Sinclair81/Lux-Air-Sensor/Lux-Air-Sensor_Bottom.png

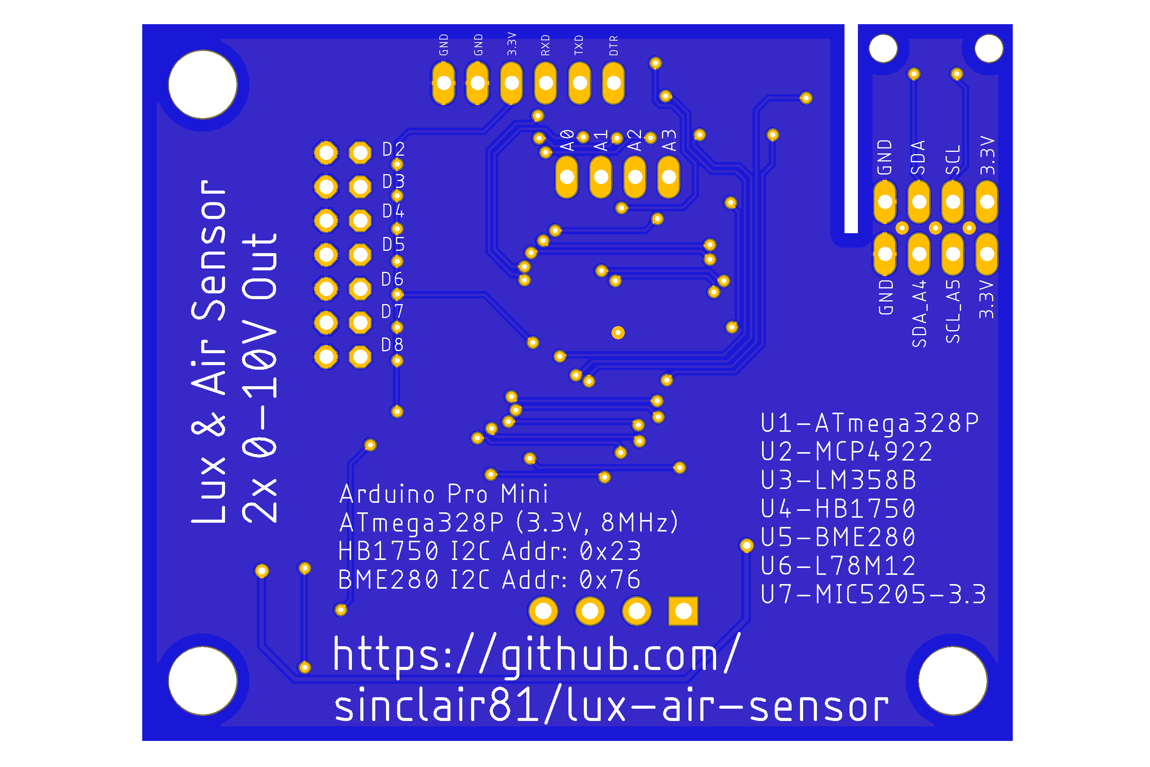
Lux-Air-Sensor_Bottom.png
