Sinclair81/Lux-Air-Sensor/Lux-Air-Sensor.pdf

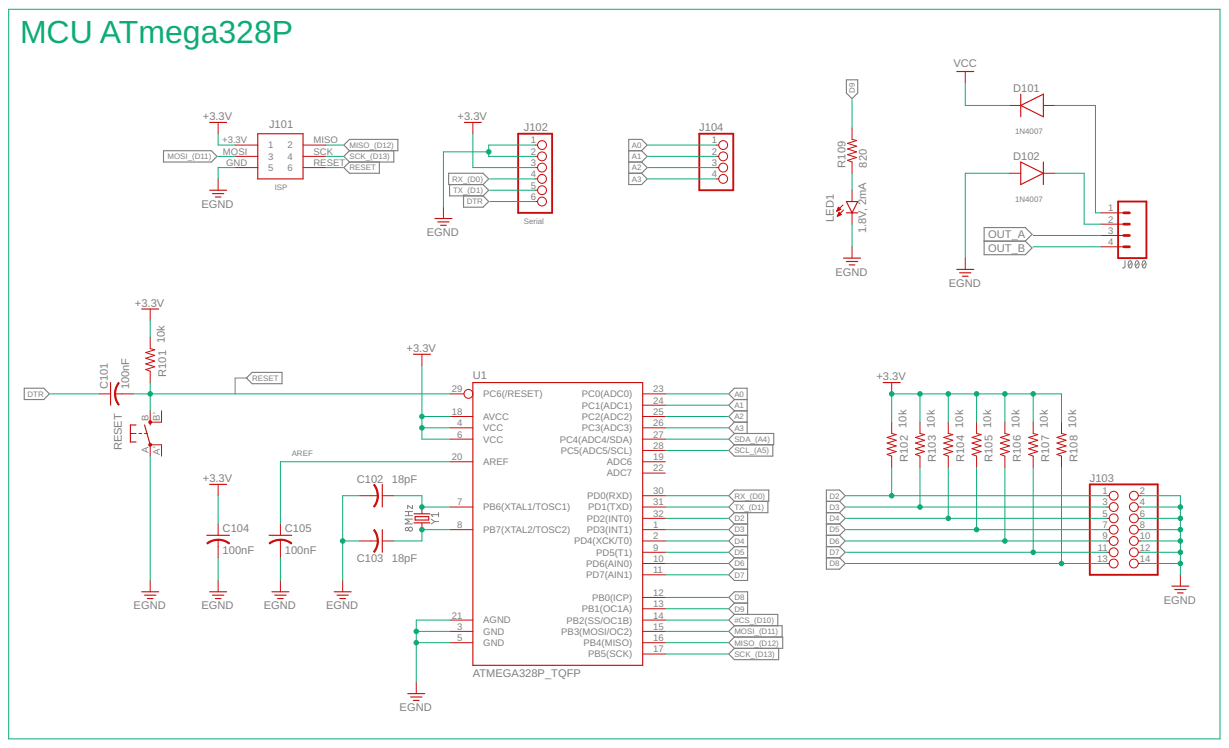
[picture p3: page 1]

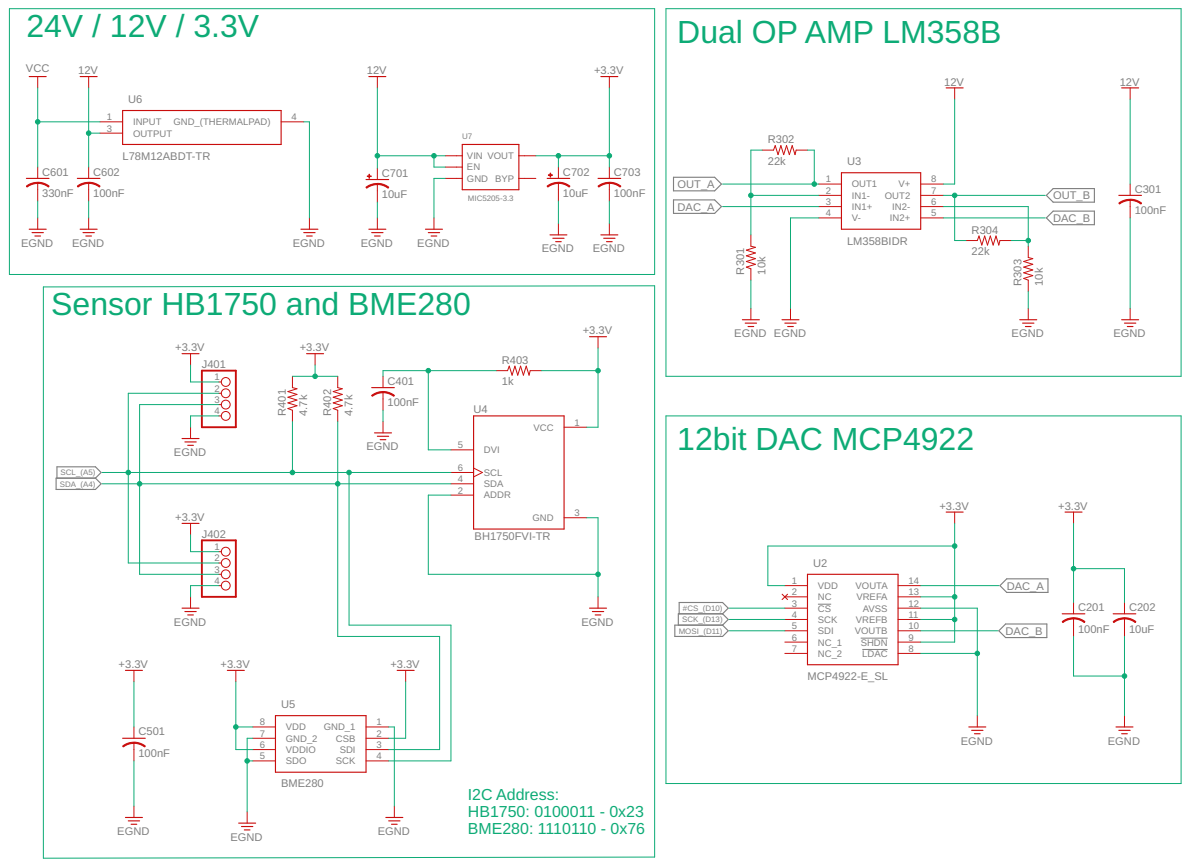
[picture p4: page 2]
