Sinclair81/Lux-Air-Sensor/Arduino Code/LED_Test/LED_Test.ino

const int ledPin = 9;

int ledState = LOW;
unsigned long previousMillis = 0;
const long interval = 500;

void setup() {
  pinMode(ledPin, OUTPUT);
}

void loop() {
  unsigned long currentMillis = millis();

  if (currentMillis - previousMillis >= interval) {
    previousMillis = currentMillis;
    if (ledState == LOW) {
      ledState = HIGH;
    } else {
      ledState = LOW;
    }
    digitalWrite(ledPin, ledState);
  }
}
